Loic-An/polyroomba/README.md

# polyroomba
roomba fait avec arduino



## Etat visuel actuel
mis a jour régulièrement
photo du robot

## Authors

- [@Loic-An](https://www.github.com/Loic-An)
- [@RemiIovino](https://github.com/RemiIovino)
