Loic-An/polyroomba/code/readme.md

# Dossier /code
Tous les fichiers relatifs au code Arduino et esp32 devraient être stockées ici.
