Loic-An/polyroomba/documentation/carnets_de_suivi/ANDRE/24-02-19.md

*******************
# Compte rendu 8
*******************
## Présentation du projet
Ce projet réalisé dans le cadre de notre cours d'arduino en PEIP2 à Polytech Nice-Sophia (prépa intégré) consiste à concevoir un robot aspirateur permettant de cartographier une pièce et de nettoyer ladite pièce de facon autonome. Nous allons pour cela utiliser une carte arduino Uno.

## Séance du 19 février 2024 (et tout travail en amont)
- Impression des nouvelles roues dentées reliant un moteur et les 2 brosses (1h d'impression).
- Après de multiples corrections sur le modèle 3D, ainsi que la modélisation du bac de rétention, nous sommes allés faire découper au fablab [l'ensemble des pièces](/images/à_découper.svg) pour réaliser au plus vite l'assemblage du robot, pour que je puisse réaliser des tests de code grandeur nature:
- Après le découpage fini (près de 20min de découpe) vient le temps de coller (avec de la colle à bois) toutes les pièces ensemble.
- Je remarque que le bac de rétention doit être réduit, puisqu'il empêche le branchement des cables des moteurs de déplacement: il doit maigrir de 2 centimètres de largeur.
- J'ai bien fait de déplacer la roue folle à l'avant, puisque tout le poids y est. Aussi, la hauteur de la roue est pairfaitement ajusté à celles des moteurs, cependant ces 3 roues sont légèrement trop basse, je pense que cela va poser problème.
- les roues dentées sont imprimées: une s'ajuste pairfaitement à l'encoche de sa brosse, l'autre à besoin de colle car les dimensions de l'encoche sont trop permissive, et enfin le trou de la roue accueillant l'axe de sortie du moteur est trop étroit: un petit ajustement à la perceuse avec un foret de 2mm et l'axe rentre pairfaitement. Les roulements s'insère correctement dans leur arbre respectif.
- Avec les roues a été imprimé une entretoise pour venir tenir en place le bras-balai à son moteur: l'ajustement est impeccable.
- Les problèmes continuent:
1. Le moteur des brosses ne tient pas en place: sa fixation est mal ajusté, à l'alimentation le moteur tournera sur lui-même (au lieu de faire tourner les roues).
2. Les brosses sont un peu proche: elles peuvent tourner à cette distance l'une de l'autre mais cela va demander un effort supplémentaire de la part du moteur (les poils de la grosse brosse viennent gener la brosse rigide).
3. Après un tour de moteur des brosses à la main, je m'aperçois que le couple requit pour actionner la pignonnerie fait sortir de leur logement les brosses: il faut concevoir une nouvelle pièce emprisonnant sur place les 2 roulements à billes ainsi que le moteurs, ou peut etre que le cache des brosses suffira à les maintenir en place (PS: pièce en cours d'impression, test plus tard en semaine).
4. [Le filtre ne tient pas en place dans le bac](/images/20240219_123118.heic), lui aussi est mal ajusté : Rémi travaille sur une nouvelle version du bac.
- Après ça, je suis allé porter assistance à divers groupes (soudures, conseils), une sorte de mini pause.
- Acquisition et réglage d'un [convertisseur buck-boost](/images/20240219_123128.heic) sur un peu moins de 13V pour alimenter le ventilateur (plage de tension: 7V-13.5V).
- L'assemblage étant bien avancé, je visse les diverses cartes au chassis, puis recable l'arduino.
