Loic-An/polyroomba/documentation/carnets_de_suivi/ANDRE/24-02-12.md

*******************
# Compte rendu 7
*******************
## Présentation du projet
Ce projet réalisé dans le cadre de notre cours d'arduino en PEIP2 à Polytech Nice-Sophia (prépa intégré) consiste à concevoir un robot aspirateur permettant de cartographier une pièce et de nettoyer ladite pièce de facon autonome. Nous allons pour cela utiliser une carte arduino Uno.

## Séance du 12 février 2024
- Je paufine le code de l'arduino, celui qui s'occupe de tout les moteurs du robot, il ne me manque plus qu'à faire un filtre passe bas (donc un circuit RC) pour lire le signal TACH du ventilo si je veux pouvoir tester si le ventilo tourne. J'ai initialement pris à M.Masson une porte NAND (qui fait office de porte NON, en mettant la deuxième entré au 5V) que je ne vais pas utilisé puisque j'ai assez de pin disponible sur l'arduino: cela va me permettre de mettre le level shifter et l'esp32 sur le shield monté sur l'uno.
- j'ai essayé la technique de mettre en entré du pont en H 12V et de mettre un rapport cyclique du signal PWM à maximum 50% (en limitant dans analogWrite(pin,val) val à 127) mais la tension moyenne en sortie est bien au dessus de 6V, vers les 10V ce qui est plutot étrange. Tant pis, de toute facon M.Masson n'a plus de batterie 12V (11.7 pour etre exact) ou ne ve pas m'en donner: je dois me contenter de [2x18650 en série](/images/20240213_212542.heic) ce qui donne une plage de tension d'alimentation entre 7.4V et 8.2V. Je donnerai en direct cette tension à l'arduino qui régulera cette tension pour lui-même, l'esp, le lidar et la partie commande des cartes moteurs, les moteurs seront alimenté par un régulateur 5V dédié (pour ne pas sur-solliciter celui de l'arduino) et enfin le ventilo sera alimenté par le biais d'un buck-boost converter calibrer sur 12V.
- J'ai testé sur générateur l'intensité que demande les 3 moteurs installé est c'est autour de 0.5A pour 5V.
- Je n'avais jamais testé le ventilo après avoir installé le filtre mais celui restreint beaucoup trop le flux d'air (le ventilo n'est pas fait pour ca après tout). J'observe presque aucun débit à 7V (voltage quand batterie a plat) et une division par 2 de l'intensité à 12V (300mA au lieu de 600mA (600mA mesuré alors que prévu à 1.32A à 12V ??)). On va donc re-designer un adaptateur ventilo-filtre pour accueillir [un(des?) plus gros filtre(s?)](/images/20240213_212525.heic), mais cette fois-ci le filtre cera encastré dans le bac et non fixé dans ladaptateur.
- Rémi m'appelle au secours sur la modélisation 3D, on est à la 7ème séance et on a toujours pas découper un chassis.
- Les moteurs sont maintenant à la vertical pour moins d'encombrement.
- L'ouverture pour les brosses est déplacé à l'arrière du chassis, ce qui entraine le déplacement du bac au millieu, et du ventilo à l'avant (oui je sais on va avoir un problème de répartition de poids, puisque la roue folle est a l'arrière).
- Il reste a dessiner :
 1. la partie engrenage des brosse, en effet les engrenages actuels n'ont pas de tête pour s'emboiter dans des roulements à billes, ducoup les brosses "flottent" et ne sont maintenus que par l'autre coté.
 2. la fixation du moteur de brosses.
 3. la fixation du moteur du bras-balai.
 4. le bac (ne bloque pas la découpe du bac).
 5. le tunnel allant de l'ouverture des brosses au bac (à faire en même temps que le bac) (impression en 3d).
- Le nouveau adaptateur ventilo-air est dessiné et placé.
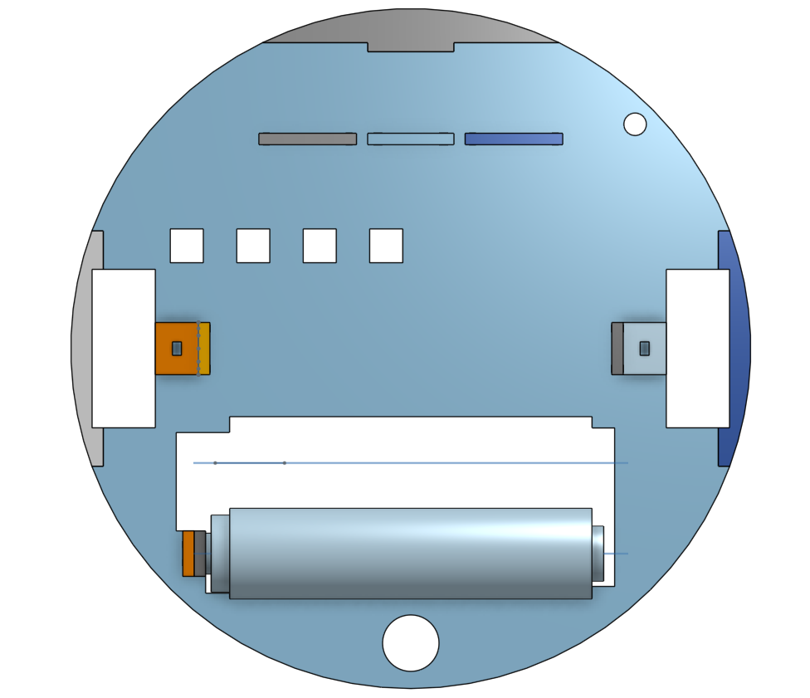
[picture p1: images/Capture d'écran 2024-02-13 212732.png]
modèle presque fini


## POST-SCRIPTUM
- nous étions reparti de zéro pour la conception, et on a oublié de replacer l'arduino dans le dessin, cela demande un ajustement supplémentaire. Une fois tout les petits détails réglés, on passe au fablab et on se fait découper le chassis, certainement mercredi ou après-midi.
