Loic-An/polyroomba/documentation/carnets_de_suivi/ANDRE/24-01-22.md

*******************
# Compte rendu 5
*******************
## Présentation du projet
Ce projet réalisé dans le cadre de notre cours d'arduino en PEIP2 à Polytech Nice-Sophia (prépa intégré) consiste à concevoir un robot aspirateur permettant de cartographier une pièce et de nettoyer ladite pièce de facon autonome. Nous allons pour cela utiliser une carte arduino Uno.

## Séance du 22 janvier 2024
- Demande d'impression en 3d de l'adaptateur ventilateur-filtre à air à M. Juan.
- Demande d'un [nouveau moteur](/images/20240123_214358.jpg) pour pouvoir mouvoir les brosses et le bras-balai.
- Qui dit moteur dit carte controlleur à moteur (puisque nous sommes interdit de montage avec mosfet et diode de roue-libre, à raison)
- Je commence à réellement me renseigner sur comment faire le repérage d'une pièce. Jusqu'ici je "repoussais" l'échéance mais là c'est le moment. Je comprends rapidement qu'il me faut faire ou trouver un algorithme dit SLAM (localisation et cartographie simultanées). Cependant ceux que j'ai trouvé sont "trop" performants pour nous: Ils ont du materiel de mesure (une camera optique) beaucoup plus adapté a ce cas de figure et donc fonctionnent sur des Nvidia Jetson et/ou on besoin d'un PC pour gérer le traitement des données et des calculs. N'ayant ni de camera ni voulant etre dependant de pc, je dois concocter une solution maison. 
Voici le plan: Le robot part d'une base (celle qu'on devrait/aurait du faire) qui représente les coordonnées (0,0) sur un plan virtuel, il s'en éloigne légèrement puis tourne sur lui même tout en prenant des mesures: une fois un tour et les points stockés, le robot vérifit la distance entre un point et son points le plus proche: si cette distance est supérieur à 30cm(largeur du robot), le robot doit se rapprocher de ces deux points et refaire un scan, on boucle jusqu'à se que tout les points aient au moins un point proche (point à une distance<30cm). Idéalement, ces déplacements pour rescanner des zones à faible précision (sans point proche) devraient aussi scanner partiellement les angles mort des scans precedents, ce qui engendrera un rapprochement du robot dans ces zones, puis un scan, etc... Ensuite le robot retourne à la base et enfin le traitement peut commencer: Tracage de contours (réduction de densité de point, transformation des points en surfaces continues, certainement plus) et création d'un chemin de nettoyage. Je ne sais pas encore ce que cela va donner mais c'est un bon début. 
Plan d'action en dessin:
plan d'action pour la découverte de pièce
- Adaptateur finalement imprimé. Tout s'assemble convenablement ensemble; Ce n'est pas étonnant au vu des tolérances que j'ai mise. Cependant jai dimensionné les trous de vis trop petit, je vais devoir trouver des vis M2x50mm....
adaptateur ventilo vers filtre à air
