Loic-An/polyroomba/documentation/carnets_de_suivi/ANDRE/24-01-18.md

*******************
# Compte rendu 4
*******************
## Présentation du projet
Ce projet réalisé dans le cadre de notre cours d'arduino en PEIP2 à Polytech Nice-Sophia (prépa intégré) consiste à concevoir un robot aspirateur permettant de cartographier une pièce et de nettoyer ladite pièce de facon autonome. Nous allons pour cela utiliser une carte arduino Uno.

## Séance du 18 janvier 2024
- Impression d'un chassis de test à l'imprimante 3D (150g pour 13h d'impression, avec un echec (merci windows update)). [Photo ici avec carte arduino, carte moteurs, moteurs et lidar](/images/20240119_175631.jpg). Ce test a permit de voir que de nombreuses côtes sont à ajuster, notamment au niveau des trous de vis des moteurs et de la carte arduino, et également le trou de la roue folle qui est mal dimensionné. Grace à ce chassis et 10 minutes de lime pour agrandir le trou de la roue folle, on a une base visuelle présentable pour l'entretien.
- Entretien de mi-parcours avec les professeurs, ce qui permet de constater le travail abattu en 4 séances et d'anticiper le fait que le robot n'aura sans doute pas de station d'accueil, par faute de temps. 
- Changement de la carte des moteurs. Lors de l'entretien, les professeurs nous ont aussi indiqué que les moteurs supportent maximum 6V et que donc le rail +12V doit etre alimenté par 6V. Ce n'est pas idéal car le ventilo à besoin de 12V. J'envisage donc de relier le 5V de l'arduino a la carte moteur et de laisser Vin à 12V, a voir si l'arduino supportera la charge. En attendant pour les test on va rester sur 6V.
- Apres recablage complet de la nouvelle carte moteur. Je branche le générateur et règle sur 6V, j'allume... et rien. La consigne de tension au générateur n'est pas maintenu et chute à 0.7V: Bizzare, pour pas dire inquiétant. Je commence à faire des tests: recablages, enlèvement du lidar et de son condensateur, enlèvement des moteurs... rien à faire, la tension chute et aucun temoin de marche, que ce soit sur la carte arduino ou celle des moteurs ne s'allume. Je démarre le multimètre pour essayer de comprendre: rail 5V de l'arduino affiche 3V, rail 6V de la carte moteur affiche 2.2V alors qu'elle est sensé etre identique à celle du générateur, qui lui affiche maintenant 1.7V. J'appelle le prof, qui constate qu'il y a un problème, cependant il doit aller quelque part, il reviendra après, cependant il a résolu le problème de chute de tension en touchant un réglage du générateur: maintenant j'ai 6v dans mon circuit, mais aussi 2.2A!!! Je laisse de coté et vais faire autre chose car j'ai déjà perdu une bonne heure et demi sur ça. 
- Je commence à faire la pièce qui fait la liaison entre le ventilateur et le filtre à air: le but est de contraindre l'air a passer par le filtre, le design est donc proche d'un réducteur. pour l'instant cette pièce est prévu pour accueillir qu'un seul filtre, selon si le flux d'air est trop contraint, il faudra rajouter des filtres(on en a 5 d'avance) ou carrément changer le ventilo (*__PS__: pièce finit le lendemain, photo ajouté en pied de page*).
- Rémi a fait les pignons qui se montent sur les brosses et le moteur, je m'occupe de les convertir en svg pour pouvoir les faire découper au laser, sauf que c'est la première fois que je fais ca donc je galère, dois installer inkscape, et quand j'ai tout finis je me rend compte que j'ai selectionné diamètre au lieu de rayon quand rémi a créer les pignons... je refais tout.
- Le prof revient vers nous proche de la fin de séance pour le problème : Il se met à tester au multimètre les tensions. Pour aller directement à la fin de lhistoire, il teste le voltage entre le 6v de la carte arduino et la masse du générateur et la s'affiche 0.1mV.... Je longe de la main le cable qui va du générateur a la carte arduino: le cable est chaud et le plastique a commencé à se déformer (normale a 2A), résultat d'une inversion de la polarité dans la rallonge de cable que jutilisais.... Je réinverse et la tout s'allume, le robot se déplace.
- Pour finir la séance, j'envoie les pignons au professeur, qui les découpe en moins de 2 minutes.

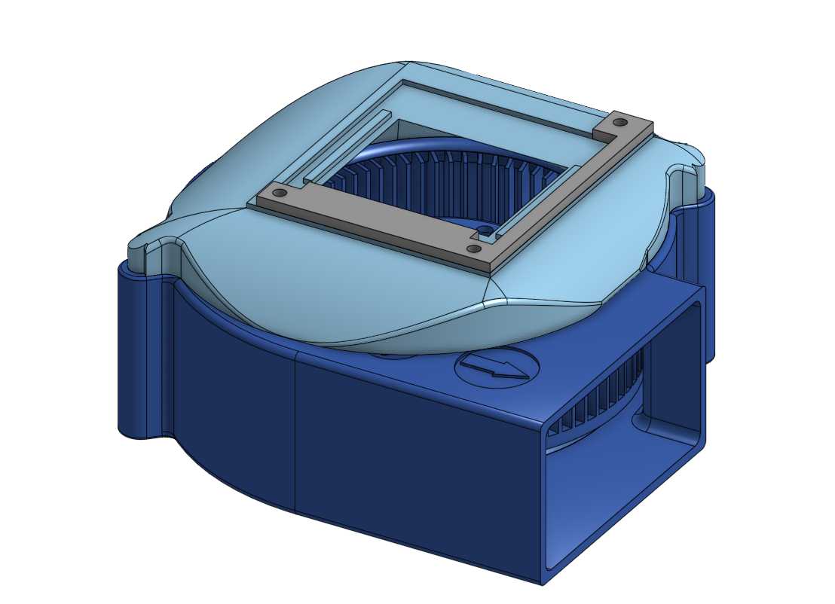
[picture p3: images/adaptateur_filtre_ventilo.png]
pièce modélisé
