Loic-An/polyroomba/documentation/carnets_de_suivi/ANDRE/24-01-11.md

*******************
# Compte rendu 3
*******************
## Présentation du projet
Ce projet réalisé dans le cadre de notre cours d'arduino en PEIP2 à Polytech Nice-Sophia (prépa intégré) consiste à concevoir un robot aspirateur permettant de cartographier une pièce et de nettoyer ladite pièce de facon autonome. Nous allons pour cela utiliser une carte arduino Uno.

## Séance du 11 janvier 2024
- Pendant les vacances, je me suis dit "ce serait bien de commencer à pouvoir déplacer le robot", ce qui m'amena à modéliser un chassis pouvant accueillir moteurs, leur controlleur, les capteurs de distances et la carte arduino, [le voici](/images/chassis_test_1.png). Cette étape de modélisation était destiné a être faite par mon binome quand il aurait pris connaissance des dimensions des balai-brosses, sauf que nous ne nous les avons pas. J'ai maintenant un modèle 3d sous format stl. Super, je me souviens qu'il reste chez moi une imprimante 3d. Bref, pour la faire courte (4 jours sont passés), je n'ai pas réussi à l'imprimer. J'ai partagé cette version à Rémi, si ca peut l'aider pour la suite.
- On arrive donc le 11 janvier en td, bien evidemment les brosses ne sont toujours pas arrivés et en plus j'oublie mon pc portable chez moi: Cela s'annonce comme 3h de pur productivité!
- Ayant quand même pris tout le materiel(moteurs,cartes,...), Rémi et moi sommes allés demander à M. Juan de nous découper au laser [un chassis de petite voiture](/images/20240111_101627.heic), pour monter les moteurs et faire les premiers tours de roue.
- la voiture est maintenant monté, les moteurs en place, la carte arduino fixé à l'aide seule de la gravité, et le tout cablé selon le [pinout prévu initialement](/code/pin.hpp). Je tire 2 cables de masse et de +12V entre le générateur DC et la carte arduino, je téléverse un code pour aller tout droit, ou du moins pour actionner les moteurs. J'allume le generateur et là, rien, pas de mouvement des moteurs. Les cables ont l'air bien branché et au bon endroit, toutes les cartes s'allument donc sont bien alimentées. J'allume le multimètre, les enables des moteur recoivent 5V mais je découvre qu'il y a 0V entre les bornes des deux moteurs: soit c'est un mauvais branchement, soit du mauvais code, soit la carte controlleur est morte, soit j'ai 2 moteurs morts.
voiture 3 roues piloté par arduino

### Post-scriptum
J'en ai eu mare d'attendre des pièces qui n'arrivent pas, alors j'en ai commandé de mon coté pendant cette séance, je les ai reçu le lendemain (au moment ou j'écris ces mots): J'ai envoyé les dimensions à Rémi et je vais essayer de faire marcher mon imprimante pour avoir quelque chose à présenter pour la semaine prochaine.
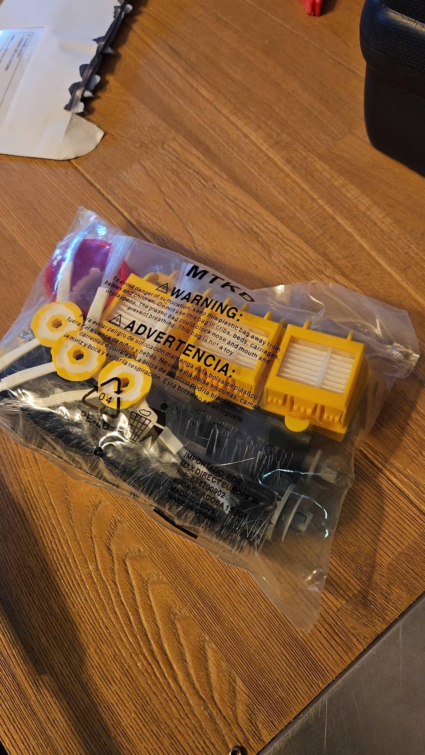
[picture p4: images/IMG_20240112_161825_477.jpg]
