Loic-An/polyroomba/documentation/carnets_de_suivi/Rapport de projet_ Le Poly’Roomba.pdf

## Rapport de projet: Le Poly’Roomba

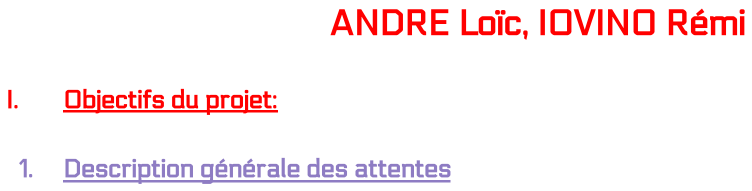
[picture p8: figure]
ANDRE Loïc, IOVINO Rémi; I. Objectifs du projet:; 1. Description générale des attentes

➔ L’objectif de ce projet est de développer un robot aspirateur ménager autonome capable d’aspirer la poussière et autres petits déchets.
➔ L’aspirateur sera capable de modéliser la pièce dans laquelle il fait le ménage, et devra pouvoir couvrir toute la surface du sol de celle-ci.
➔ Le roomba pourra s’arrêter s’il rencontre un obstacle, et changer de direction pour l’éviter. ➔ Enfin, le robot devra avoir une contenance nécessaire pour stocker les déchets sur la durée d’un ménage (voir plusieurs).
2. Cahier des charges

➔ Dans le but de créer un robot aspirateur fonctionnel et “possiblement commercialisable comme produit fini”, un cahier des charges a été établi dans l’optique de cerner au mieux les besoins et les contraintes à prendre en compte. La définition de ce cahier des charges nous a permis de gagner du temps sur la phase de conception et de réalisation.
➔ Ce cahier des charges est divisé en plusieurs sections qui sont en lien direct avec toutes les possibilités que doit offrir un aspirateur autonome, à savoir:

II. Planning déroulement projet ( initial/final )

1. Planning initial
| Ci dessous vous trouverez le planning établi initialement pour le projet, celui-ci a énormément évolué à cause des nombreuses problématiques rencontrées

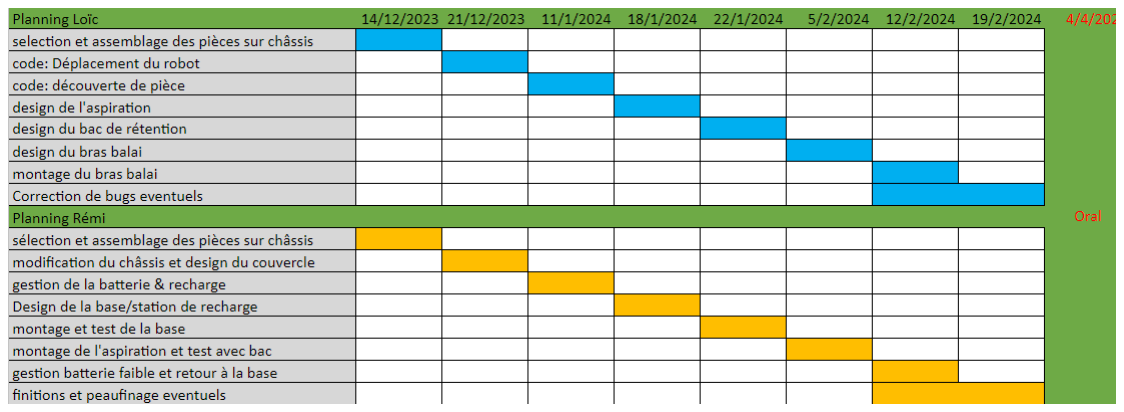
[picture p9: figure]
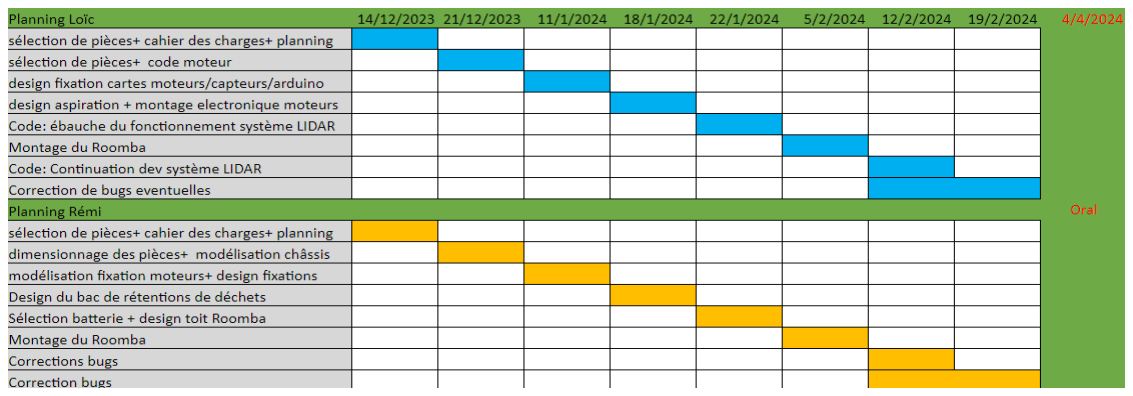
[picture p10: figure]

2. Planning Final

III. Schémas fonctionnement Roomba

1. Schémas de fonctionnement (modélisation 3D)
| ➔ Mécanisme d’aspiration: Pour comprendre le fonctionnement général du roomba il est nécessaire de détailler le fonctionnement de son système de ventilation. 1)Module aspiration génère courant d’air traversant bac et sas de collecte 2)Entraîne aspiration:déchets collectés par les brosses 3)Poussière passe dans bac par une fente 4)Filtre empêche les détritus d’entrer dans ventilateur
5) Dépôt des déchets dans le bac
| 6)Air évacuée par module d’aspiration

Modélisation 3D:vue de dessus

➔ Schéma de déplacement:
Pour la véhiculation du roomba, le système a été pensé comme tel:
1) 2 roues motrices fixées sur des moteurs, placés parallèlement au centre du roomba créent le mouvement
2) une roue folle installée à l’avant de l’aspirateur permet de maintenir la stabilité du robot
3) L’ensemble des: cartes moteurs/ carte arduino sont fixées à des supports sur châssis pour éviter toutes ruptures de courant ou autres accidents de ce genre lors du déplacement de l’aspirateur
4) Le capteur de distance est lui aussi fixé à un support à exactement 8 cm de la base avant afin de limiter la marge d’erreur liée à la mesure des distances

Modélisation 3D:vue de dessus

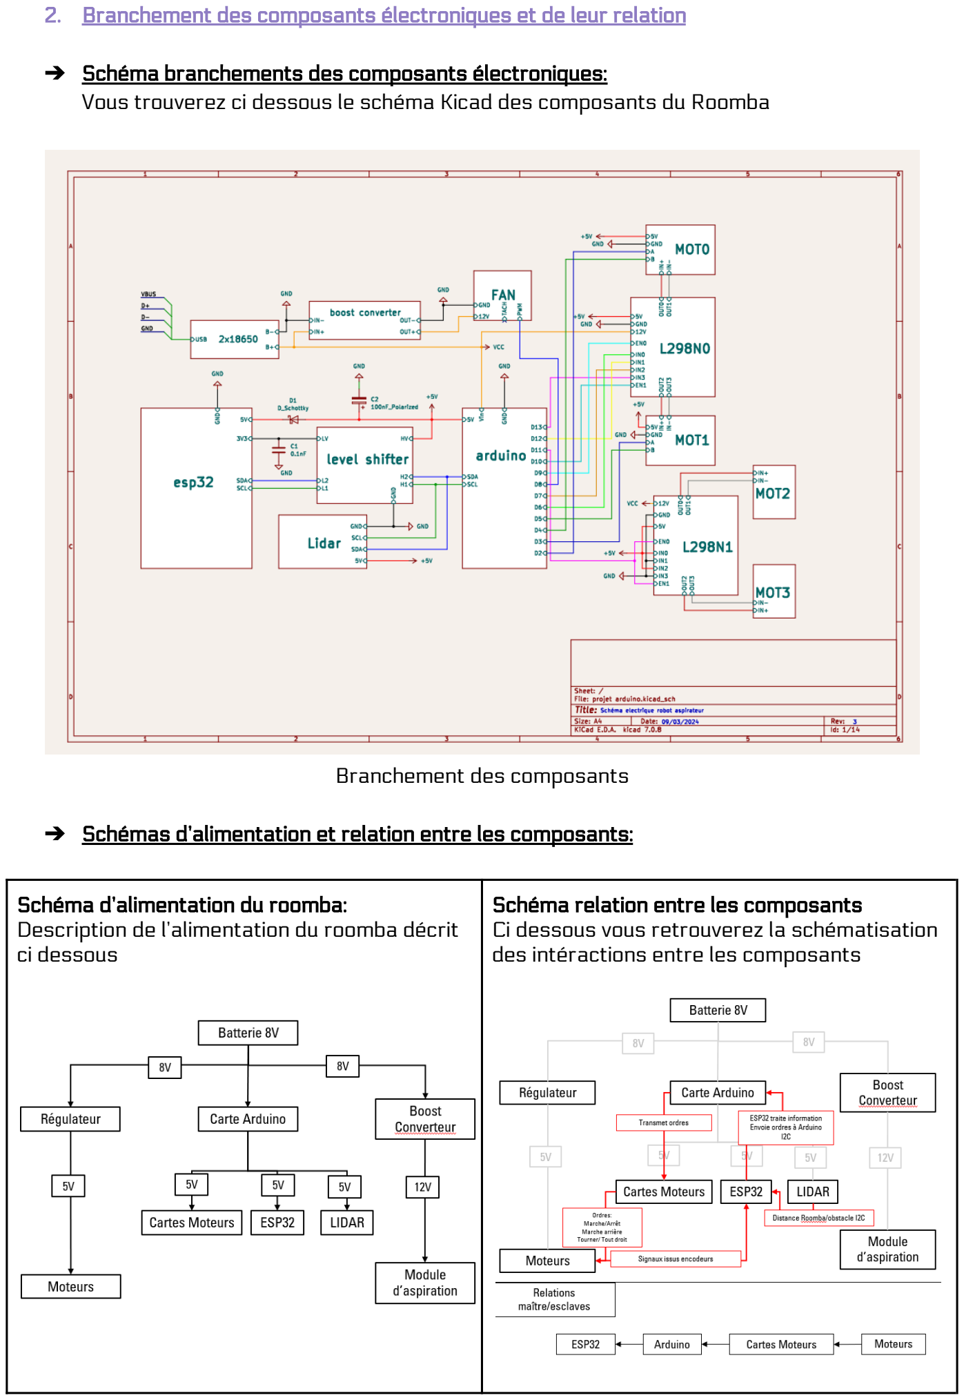
[picture p11: page 3]

2. Branchement des composants électroniques et de leur relation

➔ Schéma branchements des composants électroniques:
Vous trouverez ci dessous le schéma Kicad des composants du Roomba

Branchement des composants

➔ Schémas d’alimentation et relation entre les composants:

Schéma d’alimentation du roomba:
Description de l’alimentation du roomba décrit
ci dessous

Schéma relation entre les composants
Ci dessous vous retrouverez la schématisation des intéractions entre les composants

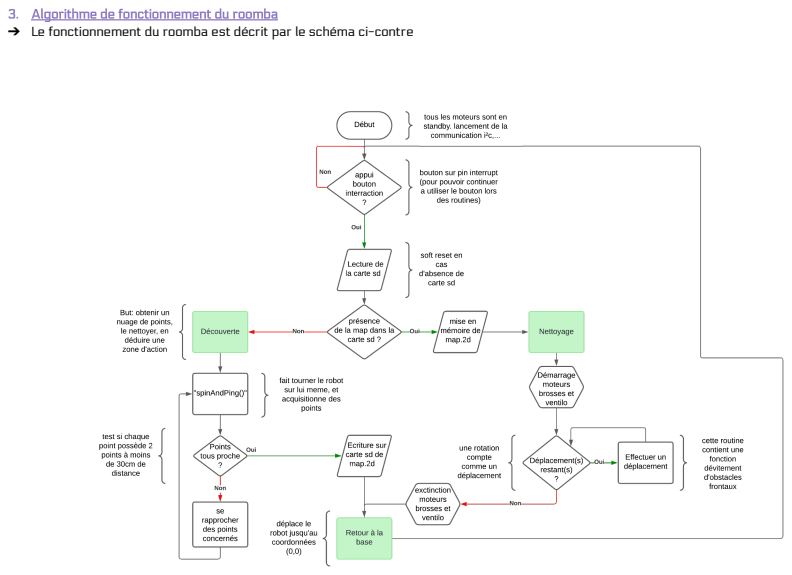
[picture p12: page 4]

3. Algorithme de fonctionnement du roomba
➔ Le fonctionnement du roomba est décrit par le schéma ci-contre

IV. Estimation du coût

1. Estimation masse salariale ( salaire d’ingénieur 38k€ annuel)
| ➔ Vous trouverez ci-dessous le détail des honoraires liés à la mission de conception et de réalisation du PolyRoomba
2. Estimation coût des composants et de fabrication

➔ Vous trouverez ci-dessous le détail de l’ensemble des dépenses liées au procédé de fabrication de l’aspirateur autonome .

➔ Ce coût englobe le coût des composants utilisés ainsi que les coûts d’impression 3D et de découpe laser sur bois.

➔ A noter que ces valeurs ne sont qu’une estimation: certaines données ne sont pas vérifiables et le prix peut varier selon les quantités de composants achetés.

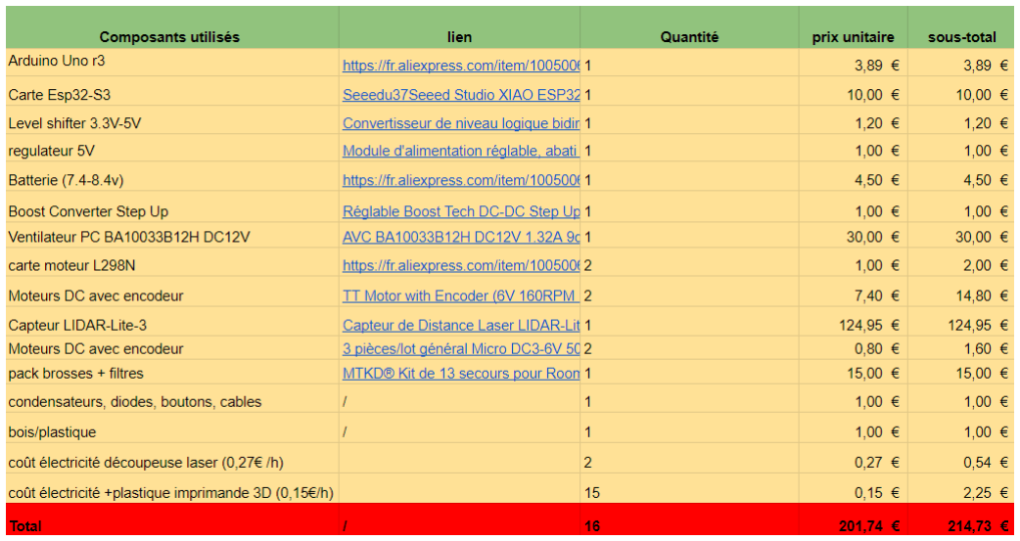
[picture p13: figure]

3. Estimation coût global

➔ Finalement après le détail des coûts liés à la conception et à la fabrication du PolyRoomba. Les dépenses pour l’ensemble du projet sont estimées à : 2478,74€

V. Conclusion
1. Problèmes rencontrés

➔ Le produit présenté et délivré n’est pas un produit fini, il n’est pas fonctionnel à souhait comme en démontre la présentation du projet qui s’est effectuée sans démonstration. Ceci est dû aux nombreux problèmes rencontrés notamment en matière de code.

➔ Le premier problème que nous avons rencontré est directement lié à la livraison des brosses du roomba, arrivées 2 semaines après la date d’arrivée initiale. Ce contretemps nous a empêché de mener à bien l’étape de dimensionage des pièces et nous a mis en retard sur l’ensemble du projet .

➔ La deuxième complication auquelle nous avons dû faire face a été l’échec du premier prototype du polyroomba: les pièces ne s’imbriquaient pas parfaitement et rendaient impossible le déplacement du roomba. Il a donc été nécessaire de modifier intégralement la maquette 3D.

➔ La dernière problématique et la plus importante a été l’écriture du code. En effet, face au retard accumulé pour la partie modélisation et conception nous avons négligé la partie informatique bien trop longtemps, or l’algorithme de cartographie de la pièce s’est avéré bien plus complexe que nous l’envisagions. Nous n’avons donc pas réussi à finir la conception du robot dans les temps.

➔ Malgré tout, les fonctions principales d’aspiration et de déplacement aléatoire ont été assurées.

2. Perspectives envisagées

➔ SI nous avions eu le double des séances, il aurait largement été possible de finaliser le projet: le robot aurait été doté de la capacité de cartographier une pièce ( et même de cartographier une habitation).

➔ De plus, il est envisageable de considérer de nombreuses améliorations possibles: nous aurions pu doter le roomba d’une borne de recharge sur laquelle l’aspirateur aurait pu venir se brancher de manière autonome , prévoir une mise en service à distance et de manière générale d’améliorer l’esthétisme du robot.

VI. Bibliographie

Contrôle moteurs DC:
➔ Arduino PID DC motor position control close loop system - Electric DIY L (https://electricdiylab.com/arduino-pid-dc-motor-position-control-close-loop-system/)

Communication ESP32, arduino:
➔ Best way to send I2C commands between Arduino and ESP32 - Arduino Stack Exchange (https://arduino.stackexchange.com/questions/72166/best-way-to-send-i2c-commands-between-arduino-and-esp32?rq=1)

Contrôle ventilateurs:
➔ 25 kHz 4 Pin PWM Fan Control with Arduino Uno | Arduino Project Hub (https://projecthub.arduino.cc/tylerpeppy/25-khz-4-pin-pwm-fan-control-with-arduino-uno-29961e)
