Loic-An/polyroomba/images/readme.md

# Dossier /images
Toutes les images du dépots devraient être stockées ici
