Loic-An/polyroomba/documentation/planning.md

# Planning Prévisionnel

Ce planning ne sera pas mis à jour
Pour voir un planning à jour, [cliquer ici](https://github.com/users/Loic-An/projects/4)

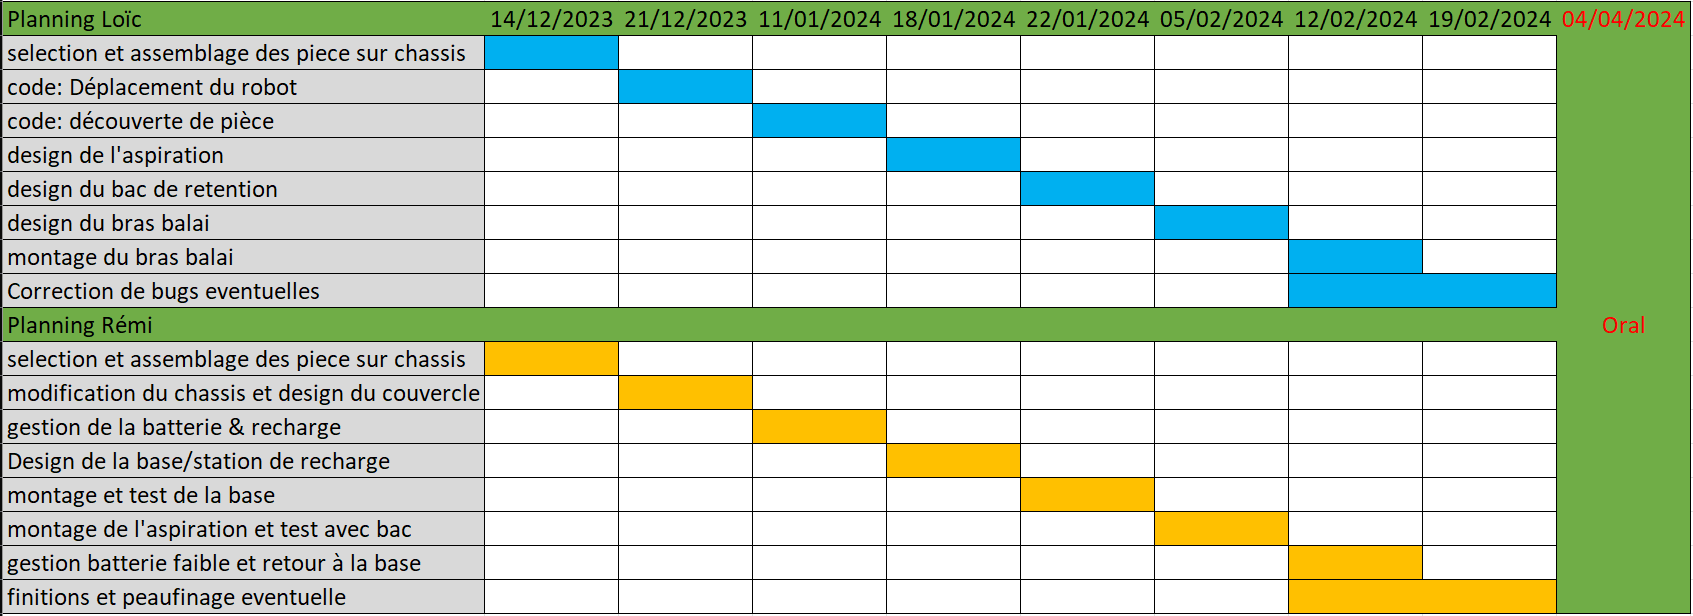
[picture p24: images/planning_initial_excel.png]
planning excel
