Loic-An/polyroomba/documentation/Diagramme robot aspi version loic.png

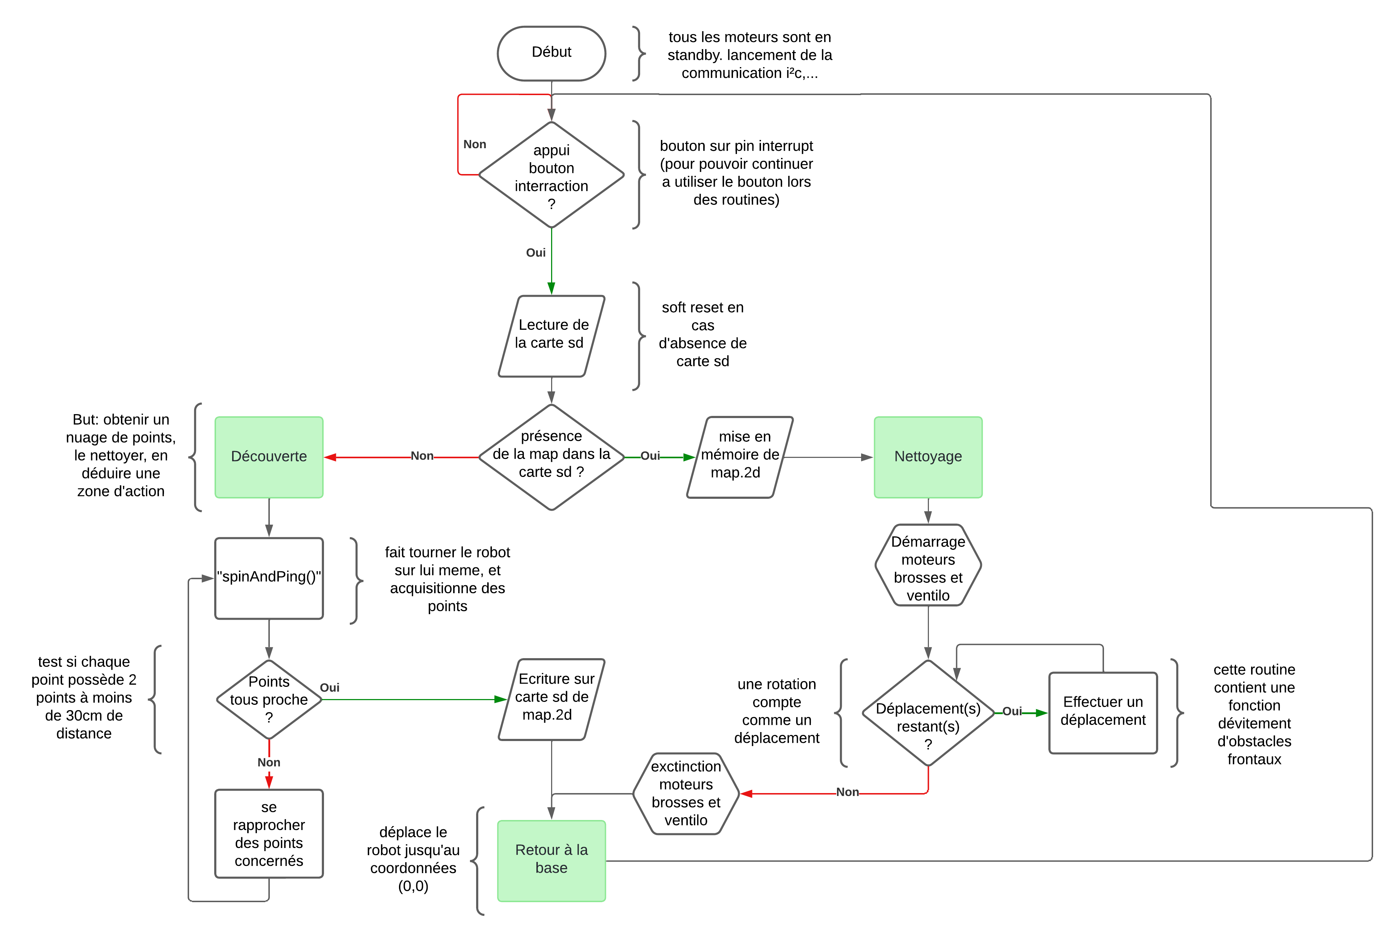
documentation/Diagramme robot aspi version loic.png
