Loic-An/polyroomba/documentation/frequence-pwm-arduino-uno-timer-pins-1024x649.jpg

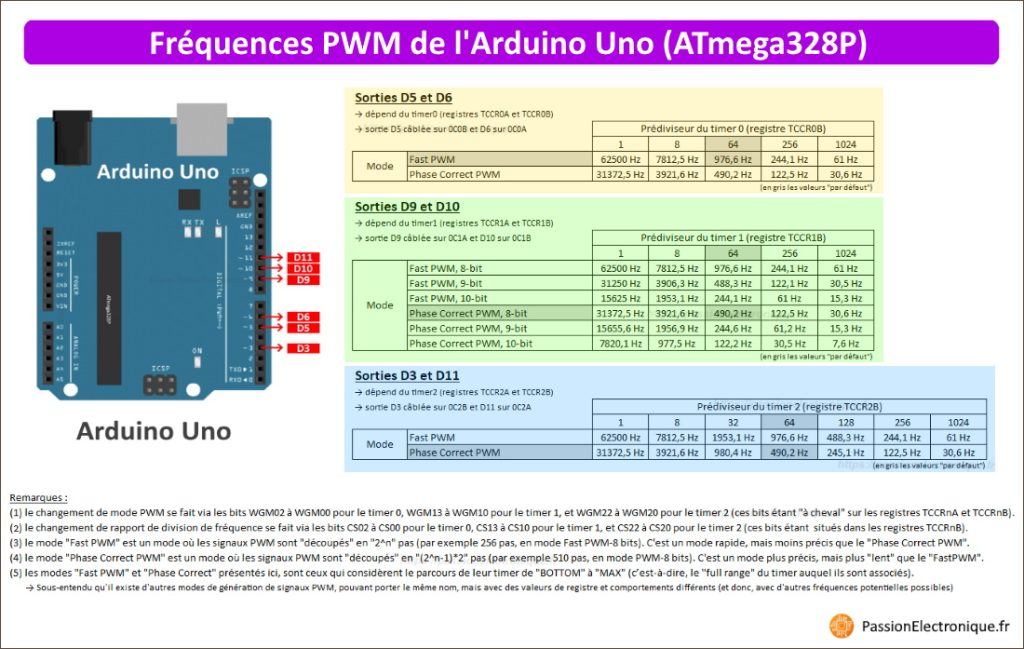
documentation/frequence-pwm-arduino-uno-timer-pins-1024x649.jpg
