Loic-An/polyroomba/images/montage_electrique_v1.png

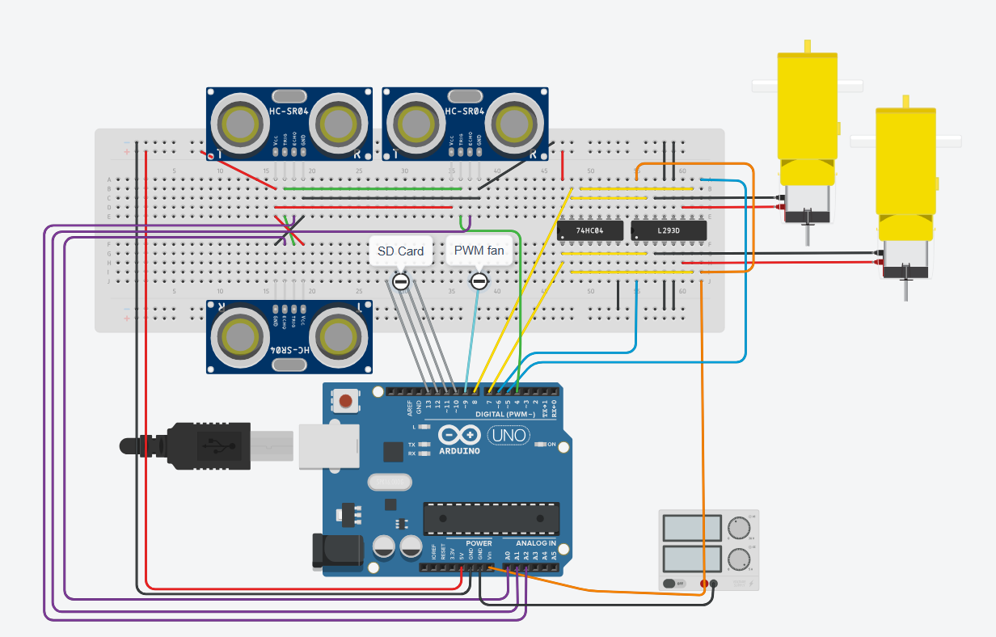
images/montage_electrique_v1.png
