Loic-An/polyroomba/images/chassis_test_1.png

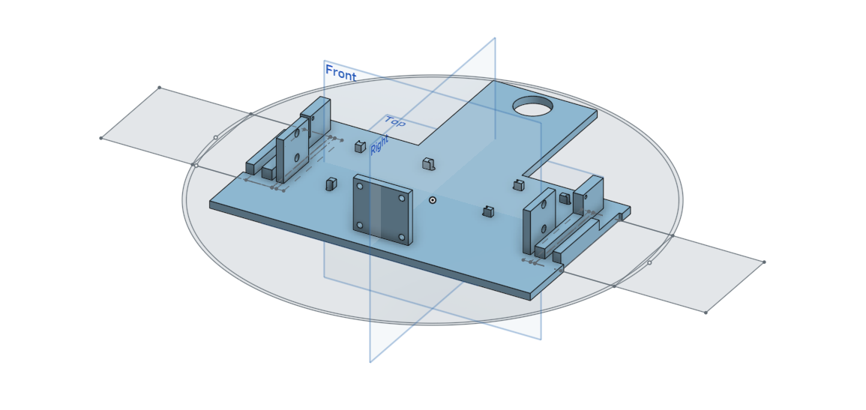
images/chassis_test_1.png
