Loic-An/polyroomba/documentation/schémaelectriquev3.pdf

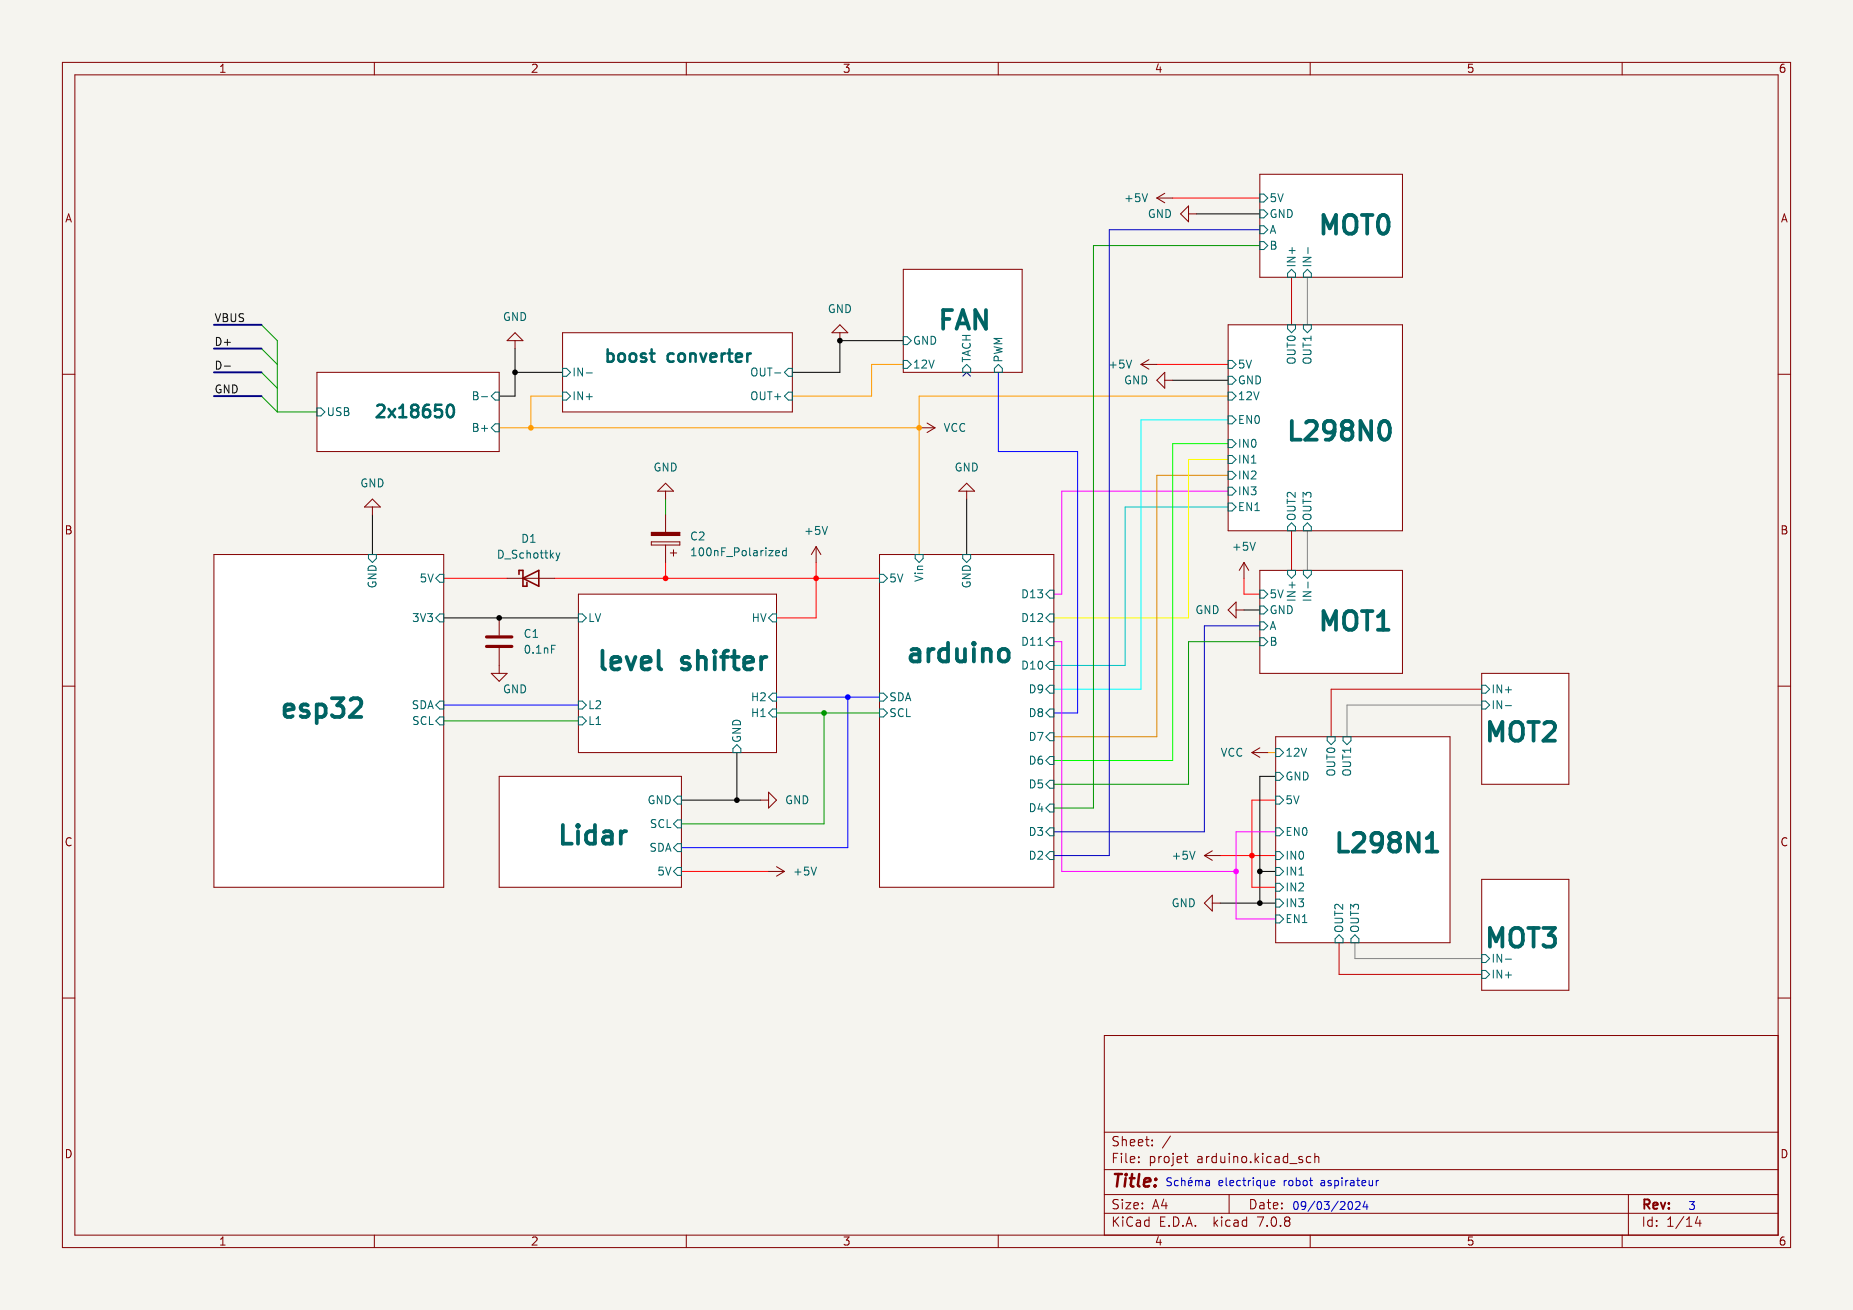
[picture p34: page 1]
