Loic-An/polyroomba/documentation/schéma_electrique_v1.pdf

A

1 | 2 | 3 | 4 | 5 | 6

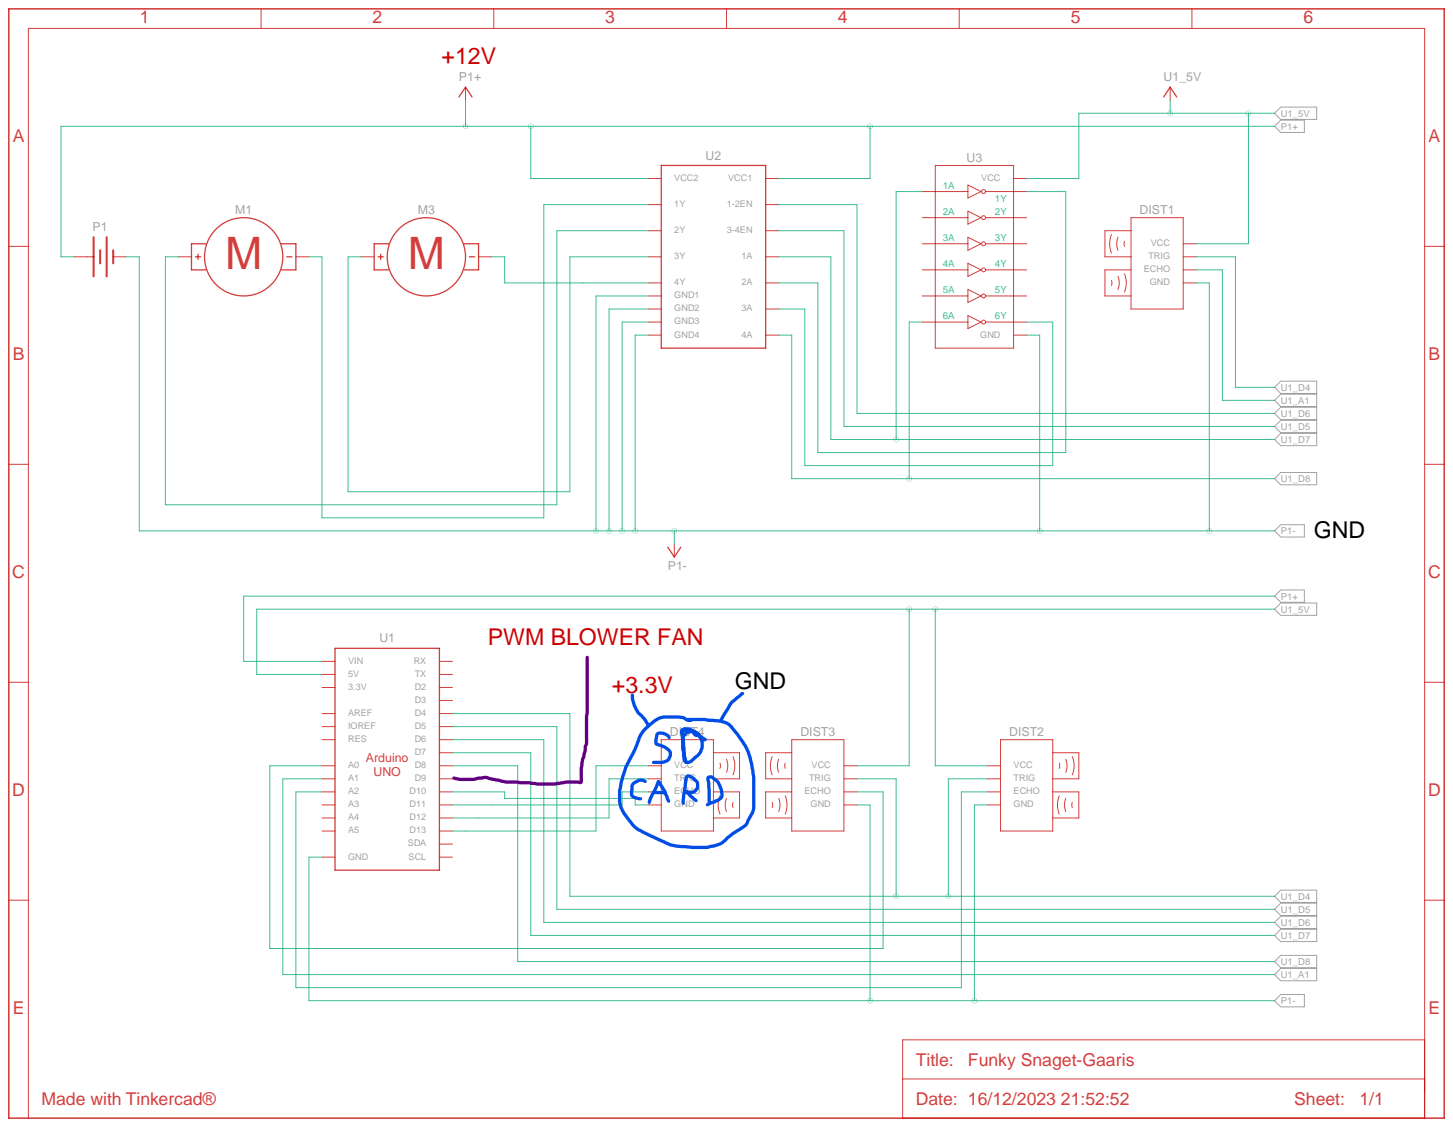
[picture p35: page 1]

Title: Funky Snaget-Gaaris
