Loic-An/polyroomba/(commit log)

2023-12-15 Réorganisation du dépôt
    [planning projetRumba Iovino.xlsx]
2023-12-15 renommage des fichiers
2023-12-17 ajout des pin dans le code
2024-01-31 création de la classe Robot
2024-02-04 bug interrupt et ecran
    [code.cpp, robot.cpp, robot.hpp]
2024-02-06 correction numero de rapport
2024-02-08 début code arduino
2024-02-08 suppression du pid de l'esp32
2024-02-13 erreur de date corrigée
2024-02-13 update code(jsp ce que jai ajouté)
2024-02-19 modification image de présentation
