Loic-An/polyroomba/(notices)

Notices in the files:
README.md:
GPLv3 License
