Loic-An/polyroomba/images/20240123_213102.jpg

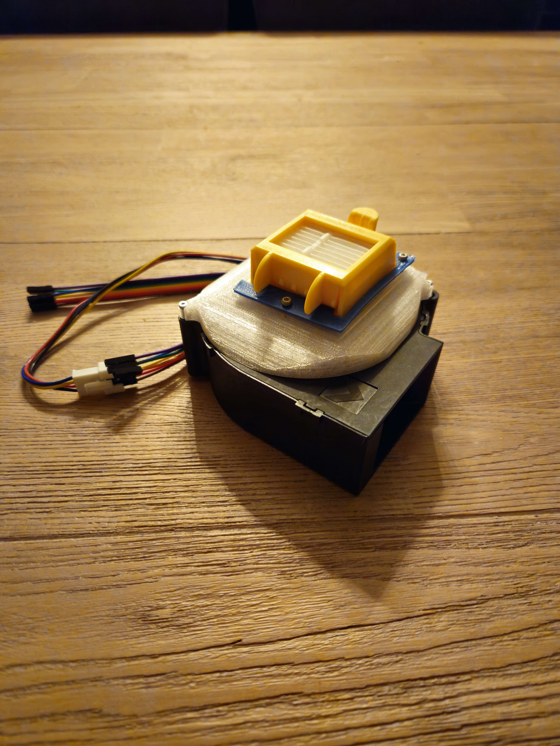
[picture p2: images/20240123_213102.jpg]
images/20240123_213102.jpg
