Loic-An/polyroomba/images/20240119_175631.jpg

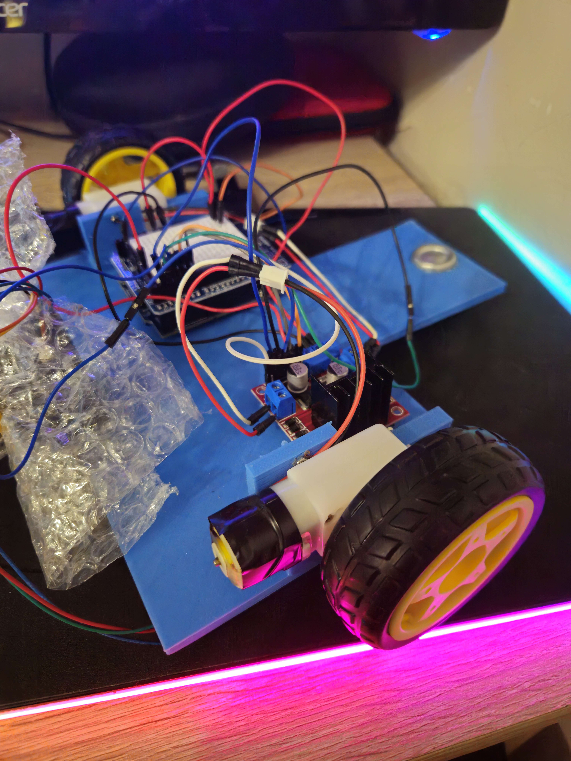
images/20240119_175631.jpg
