Loic-An/polyroomba/images/20240123_214358.jpg

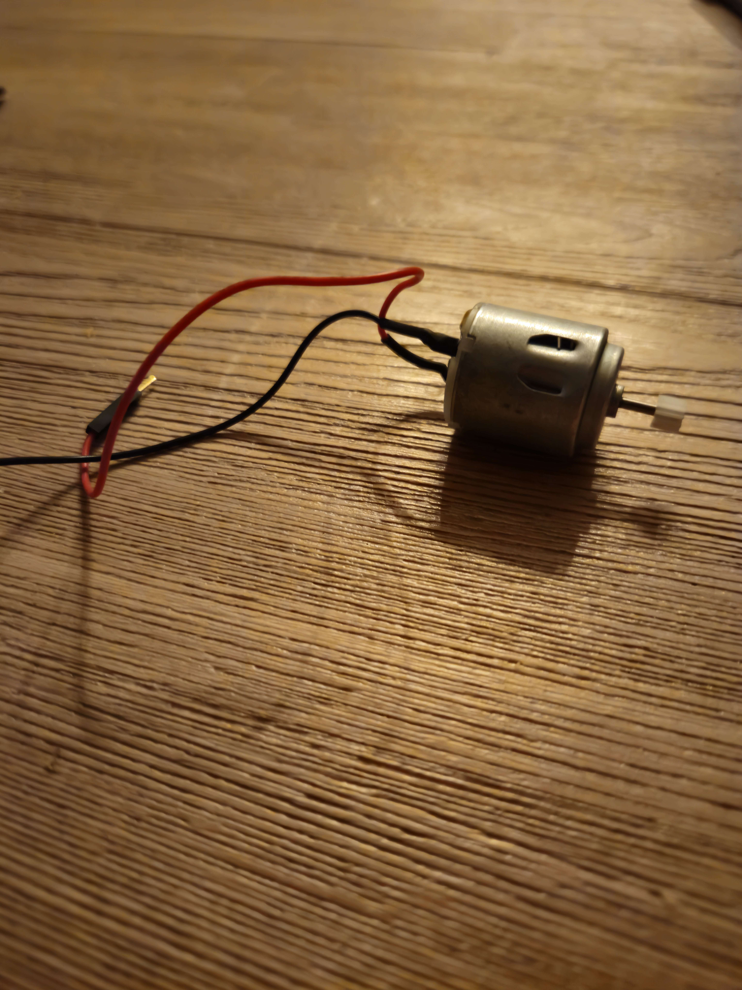
images/20240123_214358.jpg
